pawan67/helm/(commit log)

2026-07-24 Add firmware, deployment (Docker/Mosquitto/Dokploy), tests, mock device; fix instrumentation edge-DCE + standalone migrations
    [config.example.h, pullup_tracker.ino]
2026-07-25 Rebrand to HELM; add climate + buzzer, session edit/delete, Chakra redesign
    - Rebrand IRONHANG -> HELM: self-hosted home+body console. New helm-wheel logo, sectioned nav (Overview/Body/Home/System), PRODUCT.md/DESIGN.md, login, metadata.
    - Firmware: DHT11 temperature/humidity + passive buzzer with non-blocking beep scheduler; sound flags via retained MQTT config. Renamed firmware/pullup_tracker -> firmware/helm.
    - Web: Climate page (env_readings + hourly/daily aggregation, /api/env); session edit/delete with daily_stats + personal_records recompute; sound + temperature-logging settings.
    - Chakra UI v3 industrial redesign (steel + hazard theme), mock-device env, seed-env script.
    [config.example.h, helm.ino]
2026-07-25 Add IR remote design spec (Panasonic AC + Atomberg fan, HA discovery)
2026-07-25 Add IR remote: Panasonic AC + Atomberg fan, /remote console, Home Assistant discovery
    Firmware (bar node, GPIO27 via 2N2222 + IR LEDs):
    - IRremoteESP8266; subscribe pullup/<id>/ir/cmd, transmit only while IDLE so an
    IR frame never disturbs rep detection; ack on ir/ack. FW 1.2.0.
    - Panasonic AC state frames (IRPanasonicAc) + generic protocol codes (strToDecodeType).
    Server:
    - ir_devices / ir_buttons tables (migration 0002); lazy seed of Panasonic AC +
    Atomberg fan (published NEC codes), editable in-app.
    - Optimistic climate state (IR is one-way; shown as commanded, not verified).
    - API: /api/remote/{climate,fire,devices,buttons}; MQTT bridge publishes ir/cmd,
    bridges ir/ack + HA comman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
2026-07-25 Add beginner hardware wiring guide (firmware/HARDWARE.md)
    Step-by-step pin map, resistor color-code reading, and per-component polarity
    for the bar node incl. the optional IR blaster. Authored in a separate agent
    session.
2026-07-25 Fire IR immediately in any state (fw 1.2.1)
    The IDLE-only gate meant IR only sent when the VL53L0X saw nobody, so a hand near
    the sensor blocked the fan/AC. Send queued IR commands in any state instead — an
    IR burst only pauses sampling for a few tens of ms, an acceptable trade for
    instant control.
2026-07-25 Fix Docker build: create public/ so runner COPY doesn't fail
    Next.js standalone output has no public/ dir in this project, so the
    runner stage's `COPY /app/public ./public` failed on Dokploy. Create it
    in the builder stage so the copy always succeeds.
2026-07-26 Pivot design system: industrial-brutalist to friendly/premium teal
    Replace steel/hazard-amber industrial theme with a softer, rounded
    teal-led palette (Plus Jakarta Sans, larger radii) across the app
    shell, login, live/records screens, and remote UI.
2026-07-26 Fix design-audit findings: contrast, motion, touch targets, chart ticks
    Impeccable audit remediation across the teal-themed UI, all changes
    verified (WCAG contrast recomputed from OKLCH; typecheck + tests green):
    - a11y: lift fg.subtle L0.56→0.64 so small labels clear WCAG AA
    (3.85→5.33 on panel); darken danger.500/600/700 so the solid destructive
    button clears AA with its near-white ink (3.20→4.64), ramp stays monotonic.
    - perf: ih-sweep gauge beam now animates transform, not `top` (no per-frame
    layout); GPU-composited.
    - touch: climate mode/fan/swing toggles get a 44px min hit target.
    - charts: round every Y-axis tick — no more interpolated floats like
    32.349999999999994 (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
2026-07-26 docs(firmware): add ESP32 bar-node wiring diagram
    Embed the HELM Bar-Node Wiring Guide at the top of HARDWARE.md and link
    it from the firmware README, with descriptive alt text. The diagram
    matches the documented pinout (VL53L0X GPIO21/22, DHT11 GPIO25, buzzer
    GPIO26, optional IR blaster GPIO27).
2026-07-26 Theme: swap primary signal from teal to chartreuse lime
    Bold lime-on-slate direction (per reference). The primary accent scale
    (still keyed `teal` for zero-churn — every call site and CSS var renders
    lime) becomes chartreuse hue 128; INK darkened for legible text on the
    bright fill. Logo recolored teal→lime. Amber (reward), cyan (endurance),
    green (online) and red (fault) unchanged. All pairings clear WCAG AA
    (12–14:1); typecheck + tests green.
2026-07-26 Rename primary accent teal → lime; sync design docs
    Clean rename of the primary-signal token from `teal` (which held lime
    values since the last commit) to `lime` across all ~20 call sites and the
    `--chakra-colors-*` CSS vars, so the code reads honestly. Pure rename —
    rendered output is byte-identical to the shipped lime theme.
    DESIGN.md / DESIGN.json / PRODUCT.md re-synced to "Signal Lime" (hue 128):
    frontmatter values, tonal ramps, component snippets, and prose (the ground
    stays quiet; the lime signal is now bold). typecheck + 35 tests green;
    0 orphaned teal vars.
2026-07-26 feat(history): filterable sessions data table
    Replace the History page's session card-list with a data table:
    - type filter (all / pull-ups / hangs) + a themed range calendar
    (Chakra DatePicker, no native <input type=date>)
    - server-side filtering by type and local-date range, with pagination
    - select-all + bulk delete (batched daily-stats/records recompute)
    - per-row edit/delete reuse the existing SessionRowActions
    New: components/charts/sessions-table.tsx, components/ui/date-range-picker.tsx.
    API /api/sessions gains type/from/to/page/pageSize (legacy limit kept) and a
    bulk DELETE {ids}; db adds getSessionsPage() and deleteSessions().
2026-07-26 feat(home): native schedules + action-link voice shortcuts
    Two home-automation features driving the existing IR AC/fan:
    Schedules — a minute-resolution time scheduler. `schedules` table + a runner
    (lib/scheduler.ts, booted from instrumentation.ts) that fires climate patches /
    button presses through the same path the Remote UI uses. CRUD API, a Schedules
    screen (Home nav), enable toggles, day presets.
    Shortcuts — tokenized action links. `action_links` table + a public
    `GET /a/<key>` endpoint (gated by an unguessable key, not the cookie — /a added
    to proxy PUBLIC_PATHS) that fires an IR action with no login and returns a
    confirmation page, so a Bixby Quick Command / NFC tag / home-scre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
2026-07-26 feat(ha): Atomberg fan as one HA fan entity + AC swing
    - Auto-detect a fan from a generic device's Power + Speed N buttons and publish
    a single HA `fan` (on/off + speed 1..N); the mapped buttons are retired from
    HA (empty retained config) while other buttons (Boost/Sleep/Timer/LED) stay.
    Optimistic on/off + speed, best-effort (IR is one-way).
    - Add swing to the climate discovery (swing_modes + command/state topics) and
    round-trip it in the HA command handler; the AC internals already supported it.
    - New server-owned fan topics helm/fan/<id>/{on,pct}/{set,state}; new HA filters.
2026-07-26 docs: free Google Assistant → HA → Helm voice setup (no Nabu Casa)
    Step-by-step for wiring HA's manual google_assistant integration (Actions on
    Google + HomeGraph + service account + account linking) using the public
    home.pawan67.dev URL, with a ready google_assistant: config for the AC + fan.
    Includes the interim Bixby-shortcut option.
2026-07-27 fix(detection): reject phantom pull-ups/hangs from VL53L0X glitches
    The bar node was auto-counting reps and dead hangs when nobody was on
    the bar (with beeps). Root cause: the firmware only rejected VL53L0X
    RangeStatus 4 (out of range) and passed statuses 1/2/3 through with
    their garbage distances — a "signal fail" with no target often reports
    a small value, which read as a body and started a phantom session.
    - firmware: trust only RangeStatus 0; discard rep-free sessions under
    MIN_SESSION_HANG_MS (3s). Bump FW to 1.3.0.
    - detection.ts: mirror the min-session gate so the reference logic and
    mock device match the firmware.
    - mqtt.ts: server-side backstop drops rep-free sub-3s sessions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
    [helm.ino]
2026-07-27 fix(mqtt): drop trivial 1-rep phantom sessions server-side
    Phantom "1 rep / 0s hang" sets kept appearing after the firmware reflash
    (1.3.0) — with no IR LED attached, the cause is the sensor producing
    genuinely valid-looking close readings (sunlight is the prime suspect;
    all phantoms cluster late-morning/midday). The server couldn't previously
    drop these because a 1-rep phantom is indistinguishable from a real quick
    single rep.
    Widen the backstop to drop reps<=1 with no sustained hang. Accepts the
    rare loss of a real single quick rep as a trade for a phantom-free history
    while the sensor-side (long-range mode / sunlight) fix is worked out. Real
    sets (2+ reps) and any hang >= the min-sessi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
2026-07-27 fix(firmware): drop VL53L0X long-range mode to stop phantom readings
    Phantoms persisted after 1.3.0 in an open, dim space with no IR LED and
    nothing in front of the sensor — i.e. the sensor was reporting a valid
    close target from noise. LONG_RANGE lowers the signal-rate limit to reach
    far targets, which also lets weak/noisy returns register as a valid close
    reading. The bar sensor sits ~10cm from the user's head, so long range was
    never needed. Switch to VL53L0X_SENSE_DEFAULT so weak returns come back as
    signal-fail (RangeStatus != 0) and get rejected by the 1.3.0 status filter.
    Also bump the timing budget 50ms->66ms for steadier, more ambient-resistant
    readings. FW -> 1.3.1.
    [helm.ino]
2026-07-27 fix(firmware): revert to long-range + add sensor diagnostics
    Default mode dropped real detection to ~20cm (too short for a hanging
    head) AND the phantom readings persisted — so weak-signal noise was NOT
    the cause and the mode switch was wrong. Revert to LONG_RANGE to restore
    range (keep the 66ms timing budget).
    Stop guessing: stream the raw VL53L0X RangeStatus (`st`) and return signal
    rate (`sig`, MCps) with telemetry, and log any <1000mm reading server-side.
    Next misfire will show whether the false close reading carries a strong
    return (reflection / electrical garbage) or weak signal (noise) — pointing
    us at the true cause (prime suspect: a flaky sensor wire / power).
    FW -> 1.3.2.
    [helm.ino]
2026-07-27 feat(settings): expose beep toggles in the UI
    The buzzer flags (soundEnabled / beepOnRep / beepOnSessionEnd) were fully
    wired end-to-end — DB, settings API, retained MQTT config, firmware — but
    never surfaced in the settings form, so beeps couldn't be turned off from
    the web. Add a "Sound" card with a master Beeps switch plus per-rep and
    per-set-saved sub-toggles (dimmed when the master is off). Pushes to the
    ESP32 instantly over MQTT like the other settings.
2026-07-29 fix(mqtt): make broker entrypoint idempotent across restarts
    The mqtt service regenerates its password file on boot with
    `mosquitto_passwd -c`, but `restart: unless-stopped` restarts the SAME
    container and /mosquitto/config is not a volume, so the passwd file from
    the prior run persists. On the second boot mosquitto_passwd aborted with
    "Unable to open file .../passwd for writing. File exists.", set -e killed
    the script before exec mosquitto, and the broker crash-looped every ~60s.
    That downed MQTT for everything: the ESP32 got rc=-2 (MQTT_CONNECT_FAILED,
    no TCP listener) and the web app got getaddrinfo EAI_AGAIN mqtt (service
    unresolvable while cycling). rm -f the passwd (+ temp) before reg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
2026-07-29 feat(device): over-the-air firmware updates + device-health panel
    Add a System -> Device page with live device health (firmware, Wi-Fi signal, uptime, free memory, IP, last heartbeat) and over-the-air firmware updates: upload a compiled .bin in the console and push it to the bar node, which downloads it from the app, verifies the MD5, flashes the idle OTA partition, and reboots -- no USB cable.
    Firmware (1.4.0): richer retained status heartbeat (rssi/uptime/heap/ip) every 15s, plus an MQTT-triggered HTTP(S) OTA download/flash engine that streams progress on ota/status and reboots into the new image.
    Web: firmware_uploads table (image stored in-row as bytea -- no volume), /api/system/firmwa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
    [helm.ino]
2026-07-29 test(ha): include swing state in climateStateMessages expectation
    climateStateMessages has emitted a swing/state message since the AC-swing feature, but the test still expected only mode/temp/fan and was failing on main. Update the expectation.
2026-07-29 feat(remote): Panasonic AC quiet/turbo presets + horizontal swing, fan Boost/Sleep as HA preset modes
    - ir-climate: add preset (none/quiet/powerful) + swingH state, resolveClimateConfig for legacy rows
    - ha-discovery: climate preset_modes; promote fan Boost/Sleep to HA fan preset_modes
    - firmware: setQuiet/setPowerful/setSwingHorizontal; bump FW_VERSION 1.4.0 -> 1.5.0
    [helm.ino]
2026-07-31 fix(detection): guard hang-timer underflow + VL53L0X sensor-health watchdog
    - Clear the absence timer when a rep begins so a stale, pre-rep timestamp
    can't end a set early and underflow the unsigned ms clock into a garbage
    ~2^31ms "best hang" (the bogus "35791m 24s").
    - Reject implausible/errored VL53L0X reads (the 45201mm phantom) and re-init,
    then reboot, on a wedged sensor so the bar node self-heals instead of
    needing a manual power-cycle.
    - Clamp device-reported durations on MQTT ingest as defense in depth.
    - Mirror the absence/underflow fix in the detection.ts twin + add a
    regression test.
    [helm.ino]
2026-07-31 fix(history): restore Any dates button styling
    Chakra's DatePicker trigger/clearTrigger slot recipe forced our labelled
    Button/IconButton into a 24x24 fg.muted icon shape with no border/padding,
    stripping the outline control down to plain text. Pass `unstyled` so each
    child keeps its own Button/IconButton recipe.
2026-08-03 feat(remote): IR receiver + learn mode, add captured buttons to AC card
    Firmware (v1.7.0): add an IRrecv receiver on GPIO14 and an MQTT-driven
    learn flow. Server toggles capture on .../ir/learn {on,ms}; the device
    decodes any pressed remote and publishes {protocol,code,bits} on
    .../ir/learned. The receiver's ISR is enabled only during a learn window
    (auto-stops ~20s) so it never perturbs rep detection.
    Web: startIrLearn() + handleIrLearned() in mqtt.ts, POST /api/remote/learn,
    and an ir_learned live event surfaced via useLive().lastLearned. The
    button dialog gains a 'Learn from remote' action that auto-fills
    protocol/code/bits. The AC (climate) card now renders its attached buttons
    with add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
2026-08-03 feat(docs): containerize Fumadocs site + wire into Docker Compose
    Land the docs-site/ Fumadocs source and make it deployable on Dokploy
    alongside web/HA.
    - docs-site/Dockerfile: multi-stage Next.js standalone build (mirrors
    web/); deps stage copies next.config.mjs + source.config.ts so the
    fumadocs-mdx postinstall picks the Next codegen path instead of crashing
    on a missing 'vite'.
    - next.config.mjs: output 'standalone' for a small self-contained image.
    - pin packageManager pnpm@10.32.1 (same as web/): pnpm 11 turns the
    ignored-builds warning for esbuild/sharp into a hard error; 10.x warns.
    - add a 'docs' service to both compose files (dokploy: expose 3000 on
    dokploy-network; loca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
2026-08-03 docs: document IR receiver + learn mode (GPIO14, VS1838B pinout)
    Add the optional IR receiver and the learn-mode capture flow to the docs
    site (IR blaster, pin mapping, wiring, MQTT topics reference) and both
    READMEs. Bare 3-pin VS1838B parts have no labels, so the pinout is given by
    position (dome toward you, legs down: OUT/GND/VCC) with a warning that
    swapping VCC/GND can destroy the part.
2026-08-03 feat(firmware): arduino-cli build + one-command OTA (flash.sh)
    Replace the sluggish Arduino IDE loop with a headless arduino-cli wrapper
    that caches compilation. flash.sh build|usb|ota|setup: 'ota' logs in,
    uploads build/helm.ino.bin, and triggers the console's OTA push via the
    API — no browser. Bakes in the required min_spiffs partition. Adds a
    gitignored build.env (holds the console password) + example.
